FutureAIGuru/Robot/src/ComboBoard/Arduino MEGA 2560/Robot Wiring Diagram.jpg

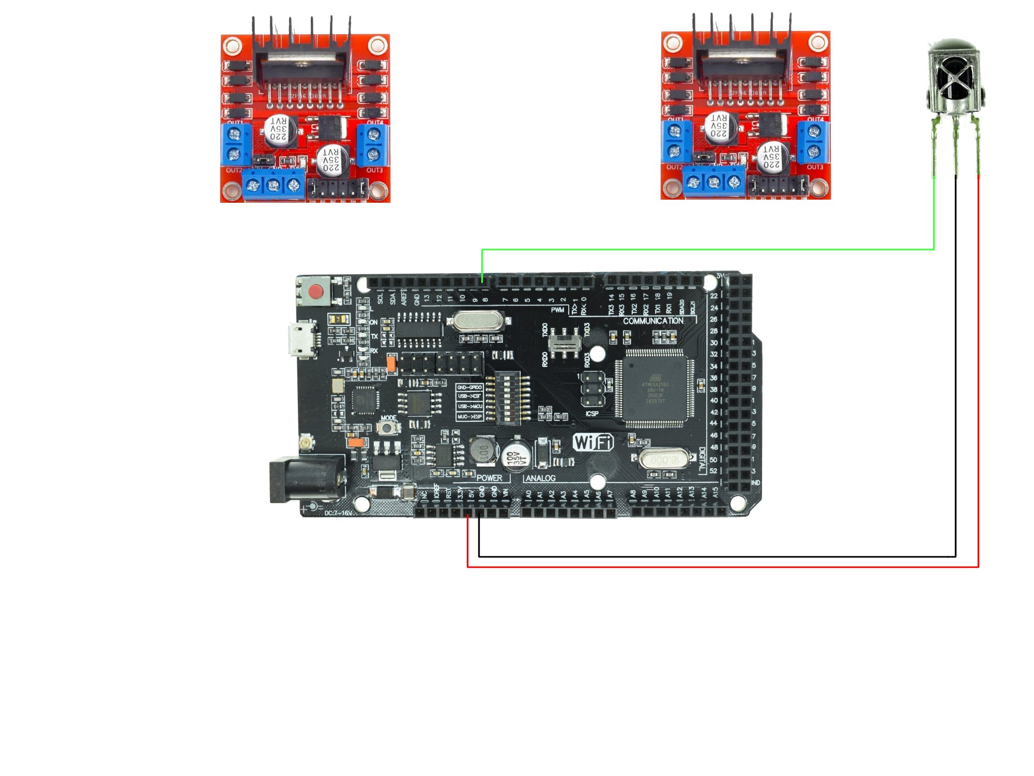
src/ComboBoard/Arduino MEGA 2560/Robot Wiring Diagram.jpg
