FutureAIGuru/Robot/src/ComboBoard/Arduino MEGA 2560/PIN Definitions.jpg

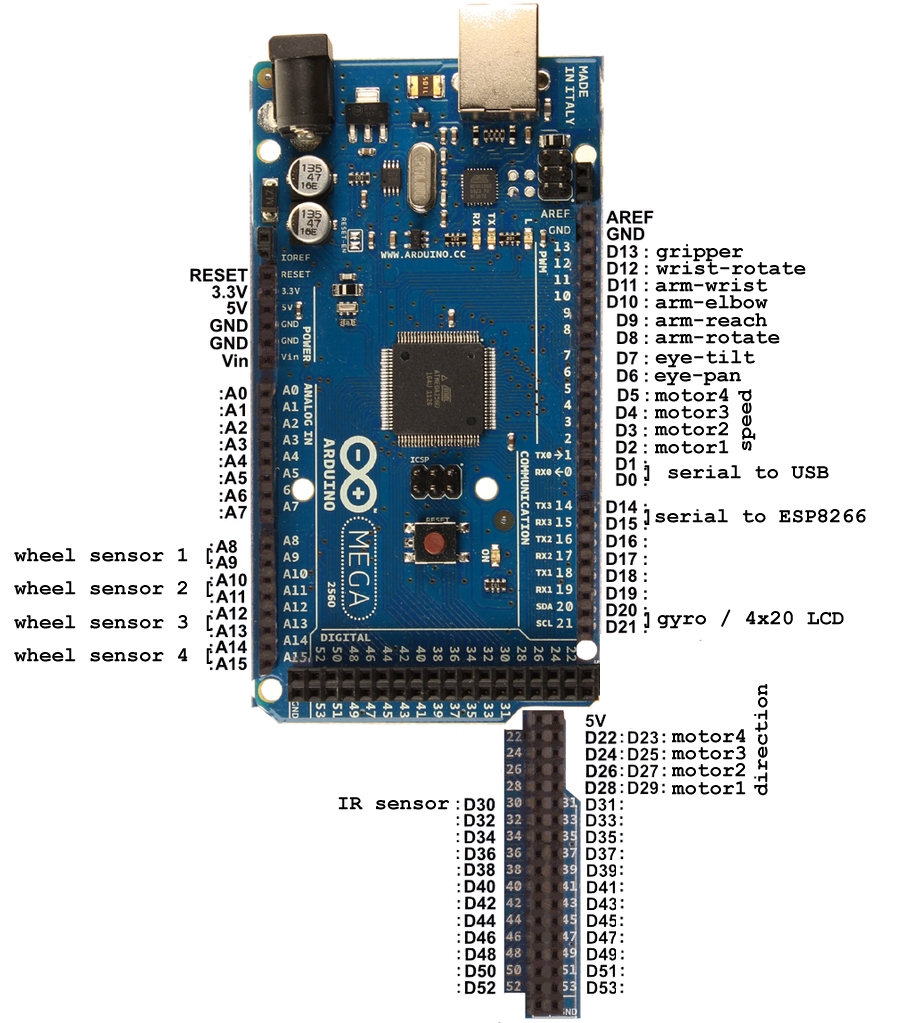
src/ComboBoard/Arduino MEGA 2560/PIN Definitions.jpg
