FutureAIGuru/Robot/experiments/README.md

This folder contains several separate software experiments, which were coded during the development phase of the robot. Many of these experiments were or will be included in the main software for the definitive design. 

The various experiments have been grouped in folders according to their respective platforms.
