FutureAIGuru/Robot/src/ESP32CAM/Camera.ino

/*
 Name:		Camera.ino
 Created:	9/23/2021 1:40:50 PM
 Author:	c_sim
*/


#include <BluetoothSerial.h>
#include <WiFi.h>
#include "esp_camera.h"
#include "esp_system.h"
#include "esp_log.h"
#include "nvs_flash.h"
#include <esp_http_server.h>
#include "Credentials.h"
#include "UDPResponder.h"

#include "CameraJpgHandler.h"


#define CAM_PIN_PWDN -1  //power down is not used
#define CAM_PIN_RESET -1 //software reset will be performed
#define CAM_PIN_XCLK 21
#define CAM_PIN_SIOD 26
#define CAM_PIN_SIOC 27

#define CAM_PIN_D7 35
#define CAM_PIN_D6 34
#define CAM_PIN_D5 39
#define CAM_PIN_D4 36
#define CAM_PIN_D3 19
#define CAM_PIN_D2 18
#define CAM_PIN_D1 5
#define CAM_PIN_D0 4
#define CAM_PIN_VSYNC 25
#define CAM_PIN_HREF 23
#define CAM_PIN_PCLK 22

#define CAM_PIN_PWDN 32
#define CAM_PIN_RESET -1 //software reset will be performed
#define CAM_PIN_XCLK 0
#define CAM_PIN_SIOD 26
#define CAM_PIN_SIOC 27

#define CAM_PIN_D7 35
#define CAM_PIN_D6 34
#define CAM_PIN_D5 39
#define CAM_PIN_D4 36
#define CAM_PIN_D3 21
#define CAM_PIN_D2 19
#define CAM_PIN_D1 18
#define CAM_PIN_D0 5
#define CAM_PIN_VSYNC 25
#define CAM_PIN_HREF 23
#define CAM_PIN_PCLK 22

static camera_config_t camera_config = {
    .pin_pwdn = CAM_PIN_PWDN,
    .pin_reset = CAM_PIN_RESET,
    .pin_xclk = CAM_PIN_XCLK,
    .pin_sscb_sda = CAM_PIN_SIOD,
    .pin_sscb_scl = CAM_PIN_SIOC,

    .pin_d7 = CAM_PIN_D7,
    .pin_d6 = CAM_PIN_D6,
    .pin_d5 = CAM_PIN_D5,
    .pin_d4 = CAM_PIN_D4,
    .pin_d3 = CAM_PIN_D3,
    .pin_d2 = CAM_PIN_D2,
    .pin_d1 = CAM_PIN_D1,
    .pin_d0 = CAM_PIN_D0,
    .pin_vsync = CAM_PIN_VSYNC,
    .pin_href = CAM_PIN_HREF,
    .pin_pclk = CAM_PIN_PCLK,

    //XCLK 20MHz or 10MHz for OV2640 double FPS (Experimental)
    .xclk_freq_hz = 20000000,
    .ledc_timer = LEDC_TIMER_0,
    .ledc_channel = LEDC_CHANNEL_0,

    .pixel_format = PIXFORMAT_JPEG, //YUV422,GRAYSCALE,RGB565,JPEG
    .frame_size = FRAMESIZE_QVGA,    //QQVGA-UXGA Do not use sizes above QVGA when not JPEG

    .jpeg_quality = 10, //0-63 lower number means higher quality
    .fb_count = 1,       //if more than one, i2s runs in continuous mode. Use only with JPEG
    //.grab_mode = CAMERA_GRAB_WHEN_EMPTY,
};

void ConnectCameraToWiFi() {
    connectToWiFi(ssid, password); //try to connect with whatever credentials...if wrong this will fail quietly

    //WiFi.setSleep(WIFI_PS_NONE);


    httpd_config_t httpdConfig = HTTPD_DEFAULT_CONFIG();

    httpd_uri_t index_uri = {
        .uri = "/",
        .method = HTTP_GET,
        .handler = jpg_httpd_handler,
        .user_ctx = NULL };

    if (httpd_start(&s_httpd, &httpdConfig) == ESP_OK)
    {
        httpd_register_uri_handler(s_httpd, &index_uri);
    }
}

// the setup function runs once when you press reset or power the board
void setup() {

    Serial.begin(115200);
    Serial.println("Starting");

    esp_err_t err = esp_camera_init(&camera_config);
    if (err != ESP_OK) {
        Serial.println("Camera Init Failed");
    }
    else {
        Serial.println("Camera Init Succeeded");
    }
    sensor_t* s = esp_camera_sensor_get();
    s->set_framesize(s, FRAMESIZE_240X240);
    s->set_quality(s, 20);

    BTInit();

    Serial.println("Reading Credientials");
    readCredentialsFromNvs(ssid, password);

    if (ssid != "") {
        ConnectCameraToWiFi();
        SetupUDPResponder();
    }
    else {
        Serial.println("No WiFi connection...use BlueTooth to connect");
    }
}



// the loop function runs over and over again until power down or reset
void loop() {
    if (bluetoothConnected == 1) {//is there a new bluetooth connection
        bluetoothConnected = 2;
        if (getWifiInfoFromBt()) {
            ConnectCameraToWiFi();
        }
    }
    //Serial.println(ESP.getFreeHeap());
}
