FutureAIGuru/Robot/src/ComboBoard/Arduino MEGA 2560/Robot/HandlePackets.h

// HandlePackets.h

#ifndef _HandlePackets_h
#define _HandlePackets_h

#if defined(ARDUINO) && ARDUINO >= 100
#include "arduino.h"
#else
#include "WProgram.h"
#endif

class Incoming {
public:
	void handleIncomingPackets();
	void setupIncomingPackets();

private:
	int getInputPacket(char* buffer, int maxSize);
	char* getNextParam();
	long getParamValue(char* param);
	char getParamCode(char* param);
};
#endif
