FutureAIGuru/Robot/src/ESP32CAM/UDPResponder.h

// UDPResponder.h

#ifndef _UDPResponder_h
#define _UDPResponder_h

#if defined(ARDUINO) && ARDUINO >= 100
	#include "arduino.h"
#else
	#include "WProgram.h"
#endif

void SetupUDPResponder();
void checkUDPAndRespond();


#endif
