FutureAIGuru/Robot/experiments/Arduino/LC_Debug/LCD_I2C/LCD_I2C.ino

#include "LCD_I2C.h"

const uint8_t rows = 4;
const uint8_t cols = 20;

LCD_I2C lcd = LCD_I2C(0x27, rows, cols);

String full_screen = "Testing the LCD_I2C |===================ABCDEFGHIJKLMNOPQRST0123456789+_/*()[]{}";
String part_screen = "1.                  2.                  3.                  4.                  ";
String empty_screen = "                                                                                ";

long start = millis();

void setup() 
{
	// put your setup code here, to run once:
	Serial.begin(9600);
	lcd.init();
	lcd.setScreen(full_screen);
	lcd.switchBacklight(true);
	lcd.switchDisplay(true);
	lcd.switchCursor(false);
	lcd.switchBlink(false);
	lcd.bufferToScreen();	
}

void loop() 
{
	// reply only when you receive data:
	if (Serial.available() > 0) 
	{
		// read the incoming byte:
		String line_in = Serial.readString();
		line_in = line_in.substring(0, line_in.length() - 1);

		// cut it up and feed it to the LCD:
		uint8_t part = 0;
		while (line_in.length() > 0)
		{
			String part_string = line_in.substring(0, cols);
			line_in = line_in.substring(cols);
			lcd.addLine(part_string);
			part += cols;
		}
	}
}
