FutureAIGuru/Robot/(commit log)

2021-09-11 First commit of the code for the ESP8266 board
2021-09-25 Initial checkin of Robot Camera
    This programs a ESP32-CAM board to act as a webcam in conjunction with the BrainSimulator RobotCamera module. You can use a bluetooth connection to connect the board to wifi. Then the board creates a webserver and every time the page (at the ip address) is accessed, it returns a jpeg of the current camera content. It is currently fixed at 320x240 resoluation.
    There is a .sln file which works with Visual Micro but it seems to work equally well in the Arduino IDE.
    [Camera.ino, CameraJpgHandler.cpp, Credentials.cpp, Credentials.h]
2021-10-20 DriveTrain Arduino mostly complete
2021-11-01 Drive Wheel tuning methods added
2021-11-14 MQTT framework up and running
2021-11-20 additions to the MQTT framework.
2021-11-26 Upgrade to support L298N Motor Controller
2021-11-27 Remove extraneous debug stmt & move .sln file to correct location (up one level)
    [HandleSensors.cpp]
2021-11-28 Added SerialTest to prove loopback via Arduino and ESP8266
2021-12-02 Added SendWheelSensorsToESP8266() on Arduino side
    const int no_of_ws_pins = 8;
    const int ws_pins[] = {"A8", "A9", "A10", "A11", "A12", "A13", "A14", "A15"};
    void SendWheelSensorsToESP8266()
    {
    for (int pin = 0; pin < no_of_ws_pins; pin++)
    {
    int val = analogRead(ws_pins[pin]);
    Serial3.print('S');
    Serial3.print(pin, DEC);
    Serial3.print(' ');
    Serial3.println(val);
    }
    }
2021-12-02 Sending wheel sensors only on signal change
2021-12-09 Copied correct files one level higher
    [OmniWheel.cpp, OmniWheel.h]
2021-12-23 WiFi access now over simple TCP/IP
    This setup uses Combo configuration of the board, and receives concept messages SEND1 and SEND0. These get relayed to the Arduino and switch the onboard LED.
2021-12-28 Revert earlier code cleanup
    [ArduinoSerialEcho.ino, HandleActuators.cpp, HandleActuators.h, HandlePackets.cpp, HandlePackets.h, HandleSensors.cpp, HandleSensors.h, Robot.ino]
2021-12-29 Moved ESP8266 into a separate 'Robot' folder
    This change was done because the code will be modified to match the Arduino code in the matching Robot folder in the Arduino section of the ComboBoard.
